LDSEmbarcatech25/emb2-chocadeira/(list of files, cad)

Other CAD files:
Modelo 3D/Assembly.iam
Modelo 3D/Inferior_plate.ipt
Modelo 3D/Superior_plate.ipt
